carrefinho/transporter/README.md

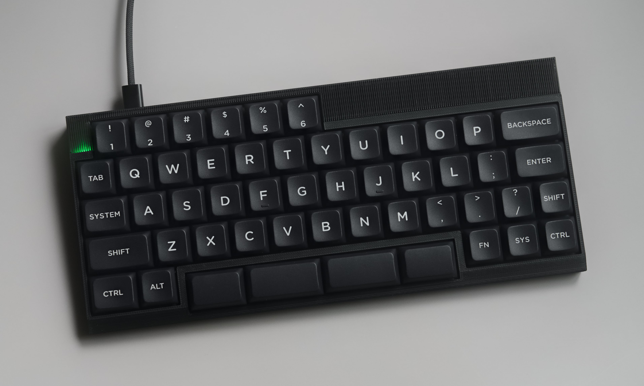
[picture p1: docs/images/transporter-hero.jpg]
Transporter keyboard with LED lit up


# Transporter

Transporter is a low-profile V4N4G0N type keyboard with exploded bars, built around the $0.5 WCH CH32X035 MCU.

## Files

- [`transporter-pcb/`](transporter-pcb/): KiCad project
    - [Interactive BOM](transporter-pcb/bom/ibom.html)
    - [JLCPCB production files](transporter-pcb/jlcpcb/production_files/)
    - [View the PCB on KiCanvas](https://kicanvas.org/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)
- [`case/facade/`](case/facade/): Facade v4 case files

## Firmware

Find the ZMK module at [transporter-zmk-module](https://github.com/carrefinho/transporter-zmk-module)

## License

[CERN-OHL-P v2](LICENSE)
