carrefinho/transporter/transporter-pcb/jlcpcb/production_files/BOM-transporter.csv

Comment | Designator | Footprint | LCSC | Quantity
CH32X035G8R6 | U1 | QSOP-28_3.9x9.9mm_P0.635mm |  | 1
1k | R4 | R_0603_1608Metric |  | 1
GREEN | D27 | LED_0805_2012Metric |  | 1
U | SW14 | SW_choc_v1v2_HS_19mmSpc |  | 1
? | SW41 | SW_choc_v1v2_HS_19mmSpc |  | 1
BAV70 | D6 | SOT-23 |  | 1
BAV70 | D20 | SOT-23 |  | 1
RST | TP1 | TestPoint_Pad_D2.0mm |  | 1
D | SW22 | SW_choc_v1v2_HS_19mmSpc |  | 1
Alt | SW45 | SW_choc_v1v2_HS_19mmSpc |  | 1
Ctrl | SW47 | SW_choc_v1v2_HS_19mmSpc |  | 1
5V | TP4 | TestPoint_Pad_D2.0mm |  | 1
USB-C 16P | J1 | USB_C_Receptacle_G-Switch_GT-USB-7010ASV |  | 1
BAV70 | D26 | SOT-23 |  | 1
4u7 | C1 | C_0805_2012Metric |  | 1
BAV70 | D8 | SOT-23 |  | 1
P | SW17 | SW_choc_v1v2_HS_19mmSpc |  | 1
Z | SW32 | SW_choc_v1v2_HS_19mmSpc |  | 1
GND | TP5 | TestPoint_Pad_D2.0mm |  | 1
L | SW28 | SW_choc_v1v2_HS_19mmSpc |  | 1
BOOT | S1 | SW_SPST_TS-1088-xR020 |  | 1
R | SW11 | SW_choc_v1v2_HS_19mmSpc |  | 1
2 | SW2 | SW_choc_v1v2_HS_19mmSpc |  | 1
C | SW34 | SW_choc_v1v2_HS_19mmSpc |  | 1
BAV70 | D1 | SOT-23 |  | 1
Win | SW46 | SW_choc_v1v2_HS_19mmSpc |  | 1
SWCLK | TP3 | TestPoint_Pad_D2.0mm |  | 1
Choc | SW51 | SW_choc_v1v2_HS_19mmSpc |  | 1
BAV70 | D16 | SOT-23 |  | 1
: | SW29 | SW_choc_v1v2_HS_19mmSpc |  | 1
BAV70 | D11 | SOT-23 |  | 1
BAV70 | D13 | SOT-23 |  | 1
S | SW21 | SW_choc_v1v2_HS_19mmSpc |  | 1
Ctrl | SW43 | SW_choc_v1v2_HS_19mmSpc |  | 1
10k | R3 | R_0603_1608Metric |  | 1
BAV70 | D15 | SOT-23 |  | 1
M | SW38 | SW_choc_v1v2_HS_19mmSpc |  | 1
H | SW25 | SW_choc_v1v2_HS_19mmSpc |  | 1
1 | SW1 | SW_choc_v1v2_HS_19mmSpc |  | 1
BAV70 | D7 | SOT-23 |  | 1
Esc | SW7 | SW_choc_v1v2_HS_19mmSpc |  | 1
BAV70 | D10 | SOT-23 |  | 1
BAV70 | D23 | SOT-23 |  | 1
Choc | SW50 | SW_choc_v1v2_HS_19mmSpc |  | 1
F SCOOP | SW23 | SW_choc_v1v2_HS_19mmSpc |  | 1
BAV70 | D17 | SOT-23 |  | 1
N | SW37 | SW_choc_v1v2_HS_19mmSpc |  | 1
Tab | SW19 | SW_choc_v1v2_HS_19mmSpc |  | 1
BAV70 | D3 | SOT-23 |  | 1
J SCOOP | SW26 | SW_choc_v1v2_HS_19mmSpc |  | 1
A | SW20 | SW_choc_v1v2_HS_19mmSpc |  | 1
BAV70 | D25 | SOT-23 |  | 1
Backspace | SW18 | SW_choc_v1v2_HS_19mmSpc |  | 1
BAV70 | D5 | SOT-23 |  | 1
, | SW39 | SW_choc_v1v2_HS_19mmSpc |  | 1
Choc | SW48 | SW_choc_v1v2_HS_19mmSpc |  | 1
I | SW15 | SW_choc_v1v2_HS_19mmSpc |  | 1
Q | SW8 | SW_choc_v1v2_HS_19mmSpc |  | 1
E | SW10 | SW_choc_v1v2_HS_19mmSpc |  | 1
O | SW16 | SW_choc_v1v2_HS_19mmSpc |  | 1
BAV70 | D4 | SOT-23 |  | 1
BAV70 | D22 | SOT-23 |  | 1
Alt | SW44 | SW_choc_v1v2_HS_19mmSpc |  | 1
W | SW9 | SW_choc_v1v2_HS_19mmSpc |  | 1
Shift | SW42 | SW_choc_v1v2_HS_19mmSpc |  | 1
T | SW12 | SW_choc_v1v2_HS_19mmSpc |  | 1
X | SW33 | SW_choc_v1v2_HS_19mmSpc |  | 1
K | SW27 | SW_choc_v1v2_HS_19mmSpc |  | 1
BAV70 | D18 | SOT-23 |  | 1
4 | SW4 | SW_choc_v1v2_HS_19mmSpc |  | 1
V | SW35 | SW_choc_v1v2_HS_19mmSpc |  | 1
Choc | SW49 | SW_choc_v1v2_HS_19mmSpc |  | 1
BAV70 | D2 | SOT-23 |  | 1
5k1 | R2 | R_0603_1608Metric |  | 1
BAV70 | D14 | SOT-23 |  | 1
5 | SW5 | SW_choc_v1v2_HS_19mmSpc |  | 1
G | SW24 | SW_choc_v1v2_HS_19mmSpc |  | 1
Y | SW13 | SW_choc_v1v2_HS_19mmSpc |  | 1
BAV70 | D24 | SOT-23 |  | 1
BAV70 | D21 | SOT-23 |  | 1
100n | C2 | C_0603_1608Metric |  | 1
3 | SW3 | SW_choc_v1v2_HS_19mmSpc |  | 1
BAV70 | D9 | SOT-23 |  | 1
SWDIO | TP2 | TestPoint_Pad_D2.0mm |  | 1
Shift | SW31 | SW_choc_v1v2_HS_19mmSpc |  | 1
B | SW36 | SW_choc_v1v2_HS_19mmSpc |  | 1
Enter | SW30 | SW_choc_v1v2_HS_19mmSpc |  | 1
5k1 | R1 | R_0603_1608Metric |  | 1
BAV70 | D12 | SOT-23 |  | 1
6 | SW6 | SW_choc_v1v2_HS_19mmSpc |  | 1
BAV70 | D19 | SOT-23 |  | 1
. | SW40 | SW_choc_v1v2_HS_19mmSpc |  | 1
