carrefinho/transporter/case/facade/transporter-case-facade-v4-top.step

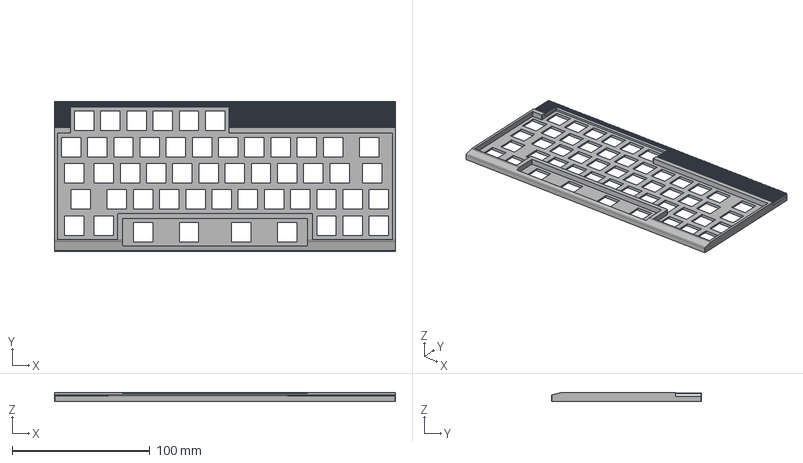
[picture p2: CAD file, 2026-10-19]
case/facade/transporter-case-facade-v4-top.step
247.3 x 108.8 x 6.80 mm
