carrefinho/transporter/transporter-pcb/transporter-exploded.step

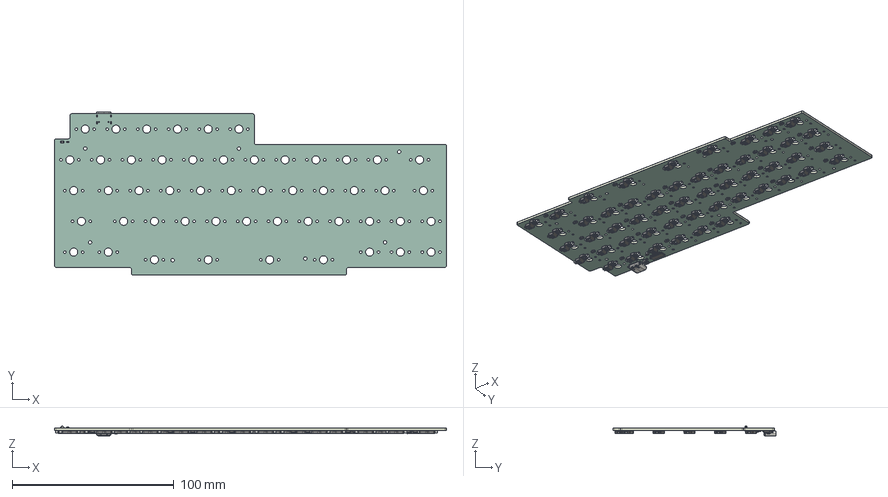
[picture p3: CAD file, 2026-10-19]
transporter-pcb/transporter-exploded.step
242.2 x 100.9 x 6.09 mm
R_0603_1608Metric x 4
LED_0805_2012Metric
pin x 102
socket x 51
SOT-23 x 26
USB_C_Receptacle_16P_TopMnt_Horizontal_GCT_USB4105-xx-A
C_0805_2012Metric
SW_SPST_TS-1088-xR020
C_0603_1608Metric
SSOP-28_3.9x9.9mm_P0.635mm
transporter_soldermask x 2
transporter_PCB
