carrefinho/transporter/case/facade/transporter-case-facade-v4-bottom.step

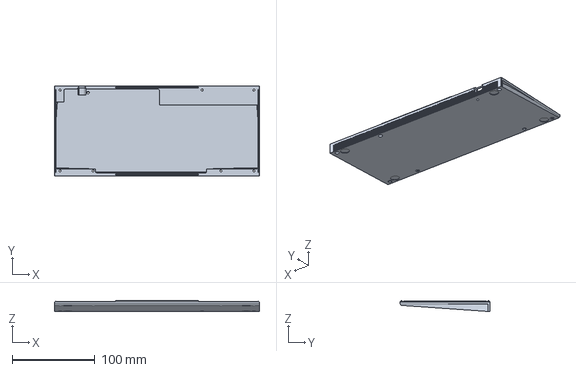
[picture p4: CAD file, 2026-10-19]
case/facade/transporter-case-facade-v4-bottom.step
247.3 x 108.8 x 13.5 mm
