carrefinho/transporter/case/facade/transporter_facade_v4_bottom.3mf

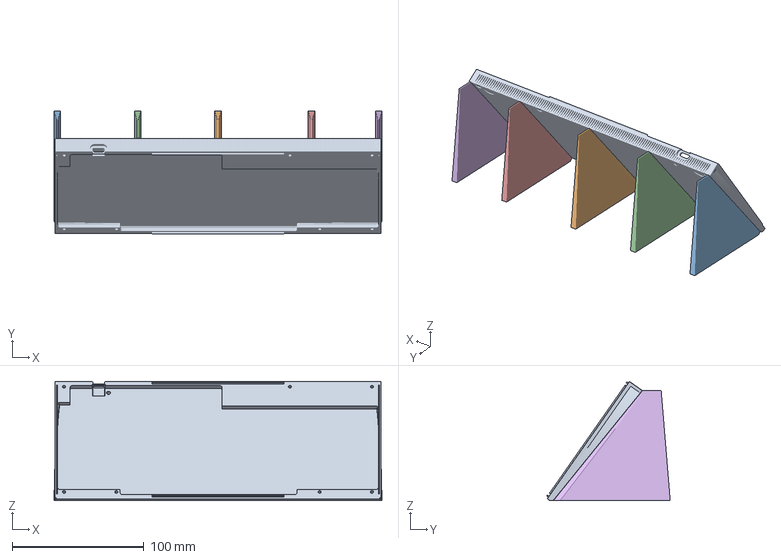
[picture p5: CAD file, 2026-10-16]
case/facade/transporter_facade_v4_bottom.3mf
249.0 x 93.7 x 90.4 mm
bottom case
