carrefinho/transporter/(list of files, cad)

Other CAD files:
case/facade/transporter_facade_v4_top_v4_petg.3mf
case/facade/transporter-case-facade-v4.f3z
