carrefinho/transporter/transporter-pcb/transporter.kicad_pcb

## KiCad design transporter-pcb/transporter.kicad_pcb (2026-10-19)

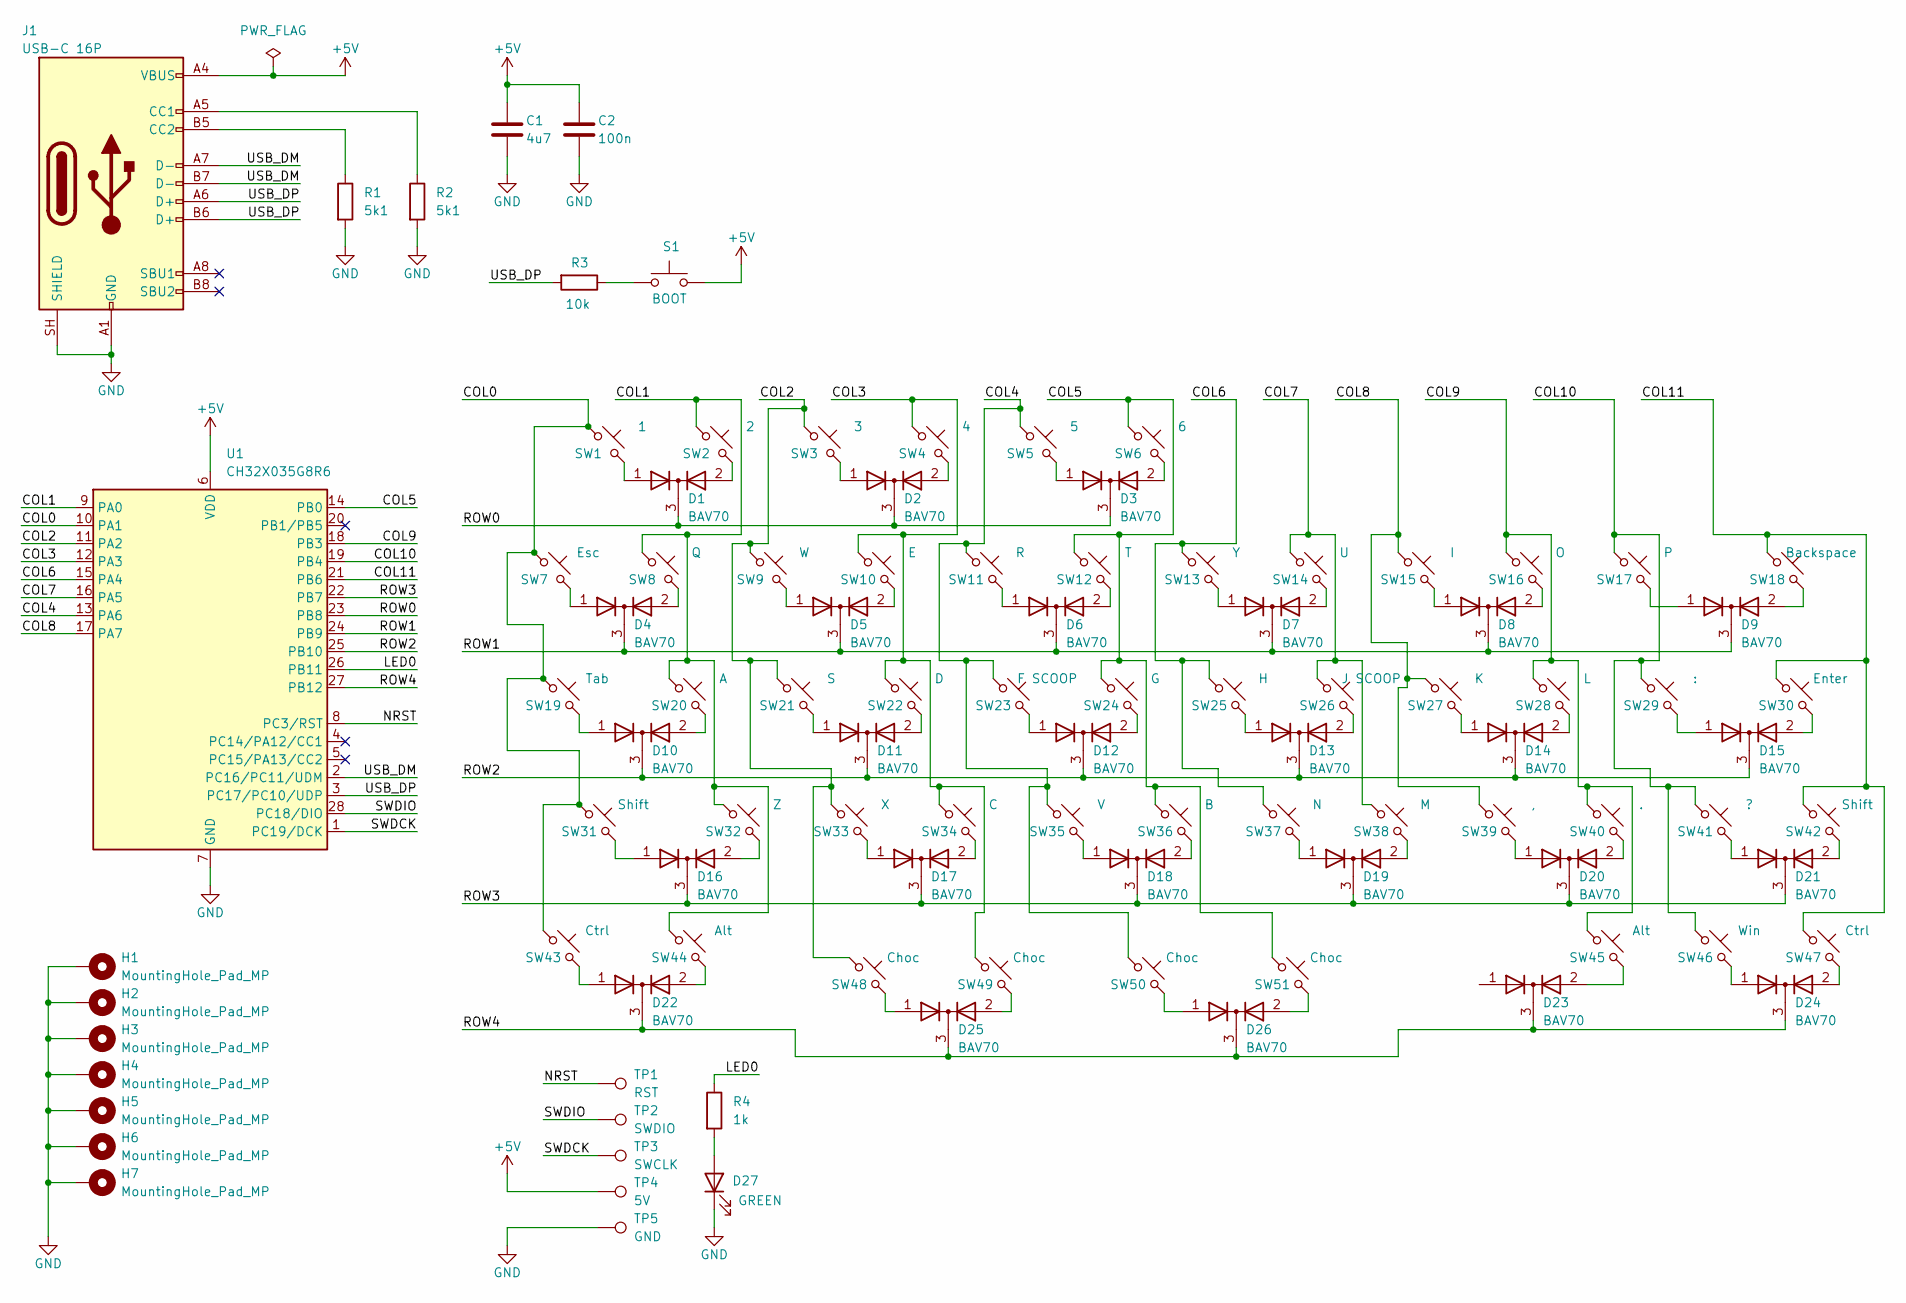
[picture p6: schematic transporter.kicad_sch]

Parts:
C1: 4u7; C_0805_2012Metric
C2: 100n; C_0603_1608Metric
D1, D2, D3, D4, D5, D6, D7, D8, D9, D10, D11, D12, D13, D14, D15, D16, D17, D18, D19, D20, D21, D22, D23, D24, D25, D26: BAV70; SOT-23
D27: GREEN; LED_0805_2012Metric
H1, H2, H3, H4, H5, H6, H7: MountingHole_Pad_MP; MountingHole_2.2mm_M2_Pad_TopBottom
J1: USB-C 16P; USB_C_Receptacle_G-Switch_GT-USB-7010ASV
R1, R2: 5k1; R_0603_1608Metric
R3: 10k; R_0603_1608Metric
R4: 1k; R_0603_1608Metric
S1: BOOT; SW_SPST_TS-1088-xR020
SW1: 1; SW_choc_v1v2_HS_19mmSpc
SW2: 2; SW_choc_v1v2_HS_19mmSpc
SW3: 3; SW_choc_v1v2_HS_19mmSpc
SW4: 4; SW_choc_v1v2_HS_19mmSpc
SW5: 5; SW_choc_v1v2_HS_19mmSpc
SW6: 6; SW_choc_v1v2_HS_19mmSpc
SW7: Esc; SW_choc_v1v2_HS_19mmSpc
SW8: Q; SW_choc_v1v2_HS_19mmSpc
SW9: W; SW_choc_v1v2_HS_19mmSpc
SW10: E; SW_choc_v1v2_HS_19mmSpc
SW11: R; SW_choc_v1v2_HS_19mmSpc
SW12: T; SW_choc_v1v2_HS_19mmSpc
SW13: Y; SW_choc_v1v2_HS_19mmSpc
SW14: U; SW_choc_v1v2_HS_19mmSpc
SW15: I; SW_choc_v1v2_HS_19mmSpc
SW16: O; SW_choc_v1v2_HS_19mmSpc
SW17: P; SW_choc_v1v2_HS_19mmSpc
SW18: Backspace; SW_choc_v1v2_HS_19mmSpc
SW19: Tab; SW_choc_v1v2_HS_19mmSpc
SW20: A; SW_choc_v1v2_HS_19mmSpc
SW21: S; SW_choc_v1v2_HS_19mmSpc
SW22: D; SW_choc_v1v2_HS_19mmSpc
SW23: F SCOOP; SW_choc_v1v2_HS_19mmSpc
SW24: G; SW_choc_v1v2_HS_19mmSpc
SW25: H; SW_choc_v1v2_HS_19mmSpc
SW26: J SCOOP; SW_choc_v1v2_HS_19mmSpc
SW27: K; SW_choc_v1v2_HS_19mmSpc
SW28: L; SW_choc_v1v2_HS_19mmSpc
SW29: :; SW_choc_v1v2_HS_19mmSpc
SW30: Enter; SW_choc_v1v2_HS_19mmSpc
SW31, SW42: Shift; SW_choc_v1v2_HS_19mmSpc
SW32: Z; SW_choc_v1v2_HS_19mmSpc
SW33: X; SW_choc_v1v2_HS_19mmSpc
SW34: C; SW_choc_v1v2_HS_19mmSpc
SW35: V; SW_choc_v1v2_HS_19mmSpc
SW36: B; SW_choc_v1v2_HS_19mmSpc
SW37: N; SW_choc_v1v2_HS_19mmSpc
SW38: M; SW_choc_v1v2_HS_19mmSpc
SW39: ,; SW_choc_v1v2_HS_19mmSpc
SW40: .; SW_choc_v1v2_HS_19mmSpc
SW41: ?; SW_choc_v1v2_HS_19mmSpc
SW43, SW47: Ctrl; SW_choc_v1v2_HS_19mmSpc
SW44, SW45: Alt; SW_choc_v1v2_HS_19mmSpc
SW46: Win; SW_choc_v1v2_HS_19mmSpc
SW48, SW49, SW50, SW51: Choc; SW_choc_v1v2_HS_19mmSpc
TP1: RST; TestPoint_Pad_D2.0mm
TP2: SWDIO; TestPoint_Pad_D2.0mm
TP3: SWCLK; TestPoint_Pad_D2.0mm
TP4: 5V; TestPoint_Pad_D2.0mm
TP5: GND; TestPoint_Pad_D2.0mm
U1: CH32X035G8R6; QSOP-28_3.9x9.9mm_P0.635mm

Connections:
+5V: C1.1, C2.1, J1.A4 (VBUS), J1.A9 (VBUS), J1.B4 (VBUS), J1.B9 (VBUS), S1.2, TP4.1 (1_1), U1.6 (VDD)
/COL0: SW1.1, SW7.1, SW19.1, SW31.1, SW43.1, U1.10 (PA1)
/COL1: SW2.1, SW8.1, SW20.1, SW32.1, SW44.1, U1.9 (PA0)
/COL2: SW3.1, SW9.1, SW21.1, SW33.1, SW48.1, U1.11 (PA2)
/COL3: SW4.1, SW10.1, SW22.1, SW34.1, SW49.1, U1.12 (PA3)
/COL4: SW5.1, SW11.1, SW23.1, SW35.1, SW50.1, U1.13 (PA6)
/COL5: SW6.1, SW12.1, SW24.1, SW36.1, SW51.1, U1.14 (PB0)
/COL6: SW13.1, SW25.1, SW37.1, U1.15 (PA4)
/COL7: SW14.1, SW26.1, SW38.1, U1.16 (PA5)
/COL8: SW15.1, SW27.1, SW39.1, U1.17 (PA7)
/COL9: SW16.1, SW28.1, SW40.1, SW45.1, U1.18 (PB3)
/COL10: SW17.1, SW29.1, SW41.1, SW46.1, U1.19 (PB4)
/COL11: SW18.1, SW30.1, SW42.1, SW47.1, U1.21 (PB6)
/LED0: R4.1, U1.26 (PB11)
/NRST: TP1.1 (1_1), U1.8 (PC3/RST)
/ROW0: D1.3 (K), D2.3 (K), D3.3 (K), U1.23 (PB8)
/ROW1: D4.3 (K), D5.3 (K), D6.3 (K), D7.3 (K), D8.3 (K), D9.3 (K), U1.24 (PB9)
/ROW2: D10.3 (K), D11.3 (K), D12.3 (K), D13.3 (K), D14.3 (K), D15.3 (K), U1.25 (PB10)
/ROW3: D16.3 (K), D17.3 (K), D18.3 (K), D19.3 (K), D20.3 (K), D21.3 (K), U1.22 (PB7)
/ROW4: D22.3 (K), D23.3 (K), D24.3 (K), D25.3 (K), D26.3 (K), U1.27 (PB12)
/SWDCK: TP3.1 (1_1), U1.1 (PC19/DCK)
/SWDIO: TP2.1 (1_1), U1.28 (PC18/DIO)
/USB_DM: J1.A7 (D-), J1.B7 (D-), U1.2 (PC16/PC11/UDM)
/USB_DP: J1.A6 (D+), J1.B6 (D+), R3.2, U1.3 (PC17/PC10/UDP)
GND: C1.2, C2.2, D27.1 (K), H1.MP, H2.MP, H3.MP, H4.MP, H5.MP, H6.MP, H7.MP, J1.A1 (GND), J1.A12 (GND), J1.B1 (GND), J1.B12 (GND), J1.SH (SHIELD), R1.2, R2.2, TP5.1 (1_1), U1.7 (GND)
unnamed: D1.1 (A), SW1.2
unnamed: D1.2 (A), SW2.2
unnamed: D2.1 (A), SW3.2
unnamed: D2.2 (A), SW4.2
unnamed: D3.1 (A), SW5.2
unnamed: D3.2 (A), SW6.2
unnamed: D4.1 (A), SW7.2
unnamed: D4.2 (A), SW8.2
unnamed: D5.1 (A), SW9.2
unnamed: D5.2 (A), SW10.2
unnamed: D6.1 (A), SW11.2
unnamed: D6.2 (A), SW12.2
unnamed: D7.1 (A), SW13.2
unnamed: D7.2 (A), SW14.2
unnamed: D8.1 (A), SW15.2
unnamed: D8.2 (A), SW16.2
unnamed: D9.1 (A), SW17.2
unnamed: D9.2 (A), SW18.2
unnamed: D10.1 (A), SW19.2
unnamed: D10.2 (A), SW20.2
unnamed: D11.1 (A), SW21.2
unnamed: D11.2 (A), SW22.2
unnamed: D12.1 (A), SW23.2
unnamed: D12.2 (A), SW24.2
unnamed: D13.1 (A), SW25.2
unnamed: D13.2 (A), SW26.2
unnamed: D14.1 (A), SW27.2
unnamed: D14.2 (A), SW28.2
unnamed: D15.1 (A), SW29.2
unnamed: D15.2 (A), SW30.2
unnamed: D16.1 (A), SW31.2
unnamed: D16.2 (A), SW32.2
unnamed: D17.1 (A), SW33.2
unnamed: D17.2 (A), SW34.2
unnamed: D18.1 (A), SW35.2
unnamed: D18.2 (A), SW36.2
unnamed: D19.1 (A), SW37.2
unnamed: D19.2 (A), SW38.2
unnamed: D20.1 (A), SW39.2
unnamed: D20.2 (A), SW40.2
unnamed: D21.1 (A), SW41.2
unnamed: D21.2 (A), SW42.2
unnamed: D22.1 (A), SW43.2
unnamed: D22.2 (A), SW44.2
unnamed: D23.2 (A), SW45.2
unnamed: D24.1 (A), SW46.2
unnamed: D24.2 (A), SW47.2
unnamed: D25.1 (A), SW48.2
unnamed: D25.2 (A), SW49.2
unnamed: D26.1 (A), SW50.2
unnamed: D26.2 (A), SW51.2
unnamed: D27.2 (A), R4.2
unnamed: J1.A5 (CC1), R2.1
unnamed: J1.B5 (CC2), R1.1
unnamed: R3.1, S1.1

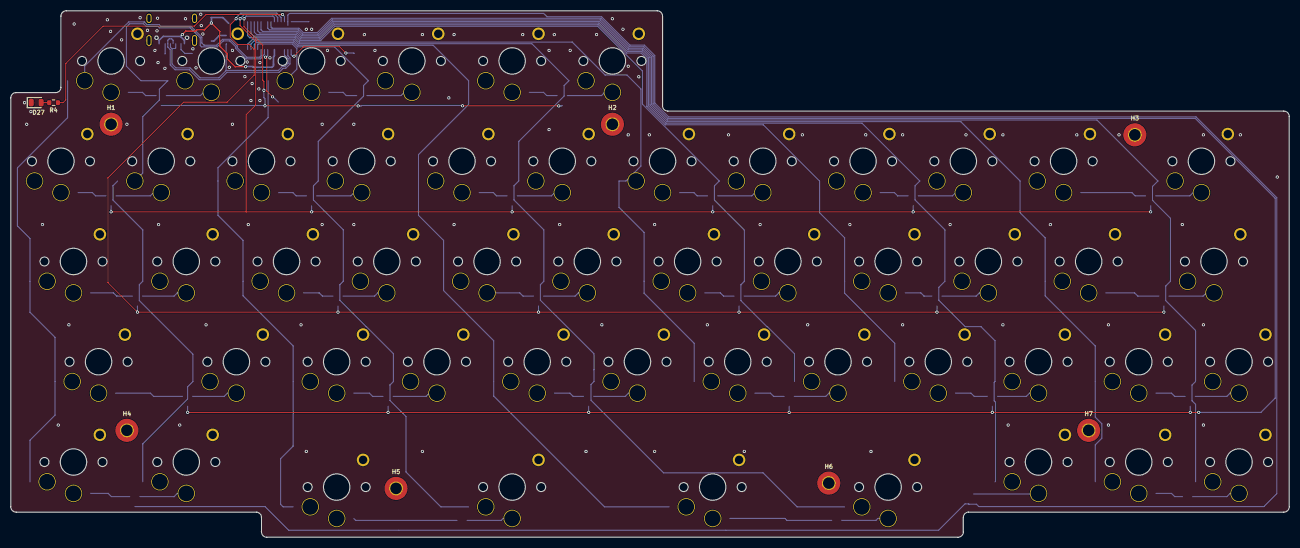
[picture p7: board transporter.kicad_pcb from above]

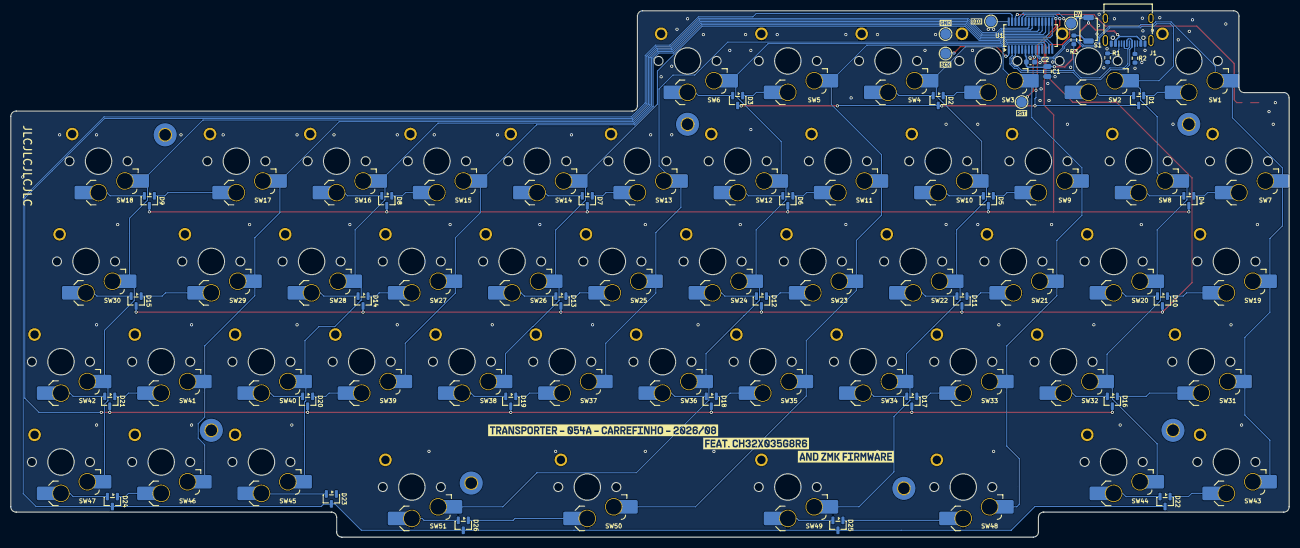
[picture p8: board transporter.kicad_pcb from below]

Board: 2 copper layers, 242.2 x 99.8 mm, 107 parts (98 on the bottom side), 80 nets.

Other parts of the board:
kibuzzard-6A81B6A9: G***; kibuzzard-6A81B6A9
kibuzzard-6A81B43D: G***; kibuzzard-6A81B43D
kibuzzard-6A81B44A: G***; kibuzzard-6A81B44A
kibuzzard-6A81B46A: G***; kibuzzard-6A81B46A
kibuzzard-6A81B62F: G***; kibuzzard-6A81B62F
kibuzzard-6A81B412: G***; kibuzzard-6A81B412
kibuzzard-6A81B455: G***; kibuzzard-6A81B455
kibuzzard-6A81B684: G***; kibuzzard-6A81B684
