carrefinho/transporter/(commit log)

2026-10-16 add facade v4 case files
    [transporter-case-facade-v4.f3z, transporter-case-facade-v4.step, transporter_facade_v4_top_v4_petg.3mf]
2026-10-16 add facade v4 bottom case 3mf
    [transporter_facade_v4_bottom.3mf]
2026-10-19 add KiCad project along with BOM and GERBER files
    [BOM-transporter.csv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]
2026-10-19 case: update files
    [transporter-case-facade-v4-bottom.step, transporter-case-facade-v4-top.step, transporter-case-facade-v4.f3z, transporter-case-facade-v4.step, transporter_facade_v4_top_v4_petg.3mf]
